victorconka/emergency_button/README.md

# Emergency Button  
## About  
"emergency button" project based on attiny85, nrf24l01, esp8266 based devboard, telegram and email API's  
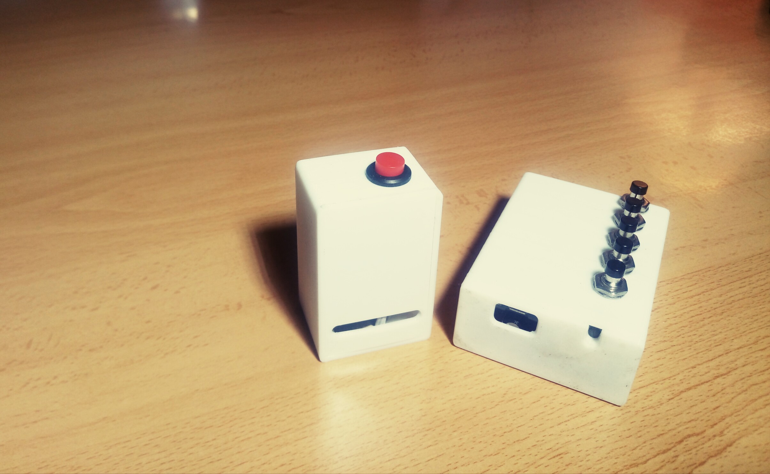
[picture p1: imgs/IMG_20171120_012127_170.jpg]
Server and Emergency Button
  
### Main funcions:  
*     	Attend Telegram Commands.  
*     	Telegram Authorization (access control).  
*     	Listen for the Alert button being pressed.  
*     	Send WOL packet to the PC.  
*     	Send Ping packets to the configured IP Address.  
### Folder contains:  
* UML project files.  
* Enclosure for both, button and server. (opensource, not mine).  
* libraries used to compile arduino files for the server since the compilation is tricky because of the number of libraries used and available SRAM.  
* The code for Arduino IDE.  
* Schematics for the circuits (be aware that some of the part libraries were missing, so same shape parts were used.)  
  
## Configuration  
### Server  
#### Schematic:  
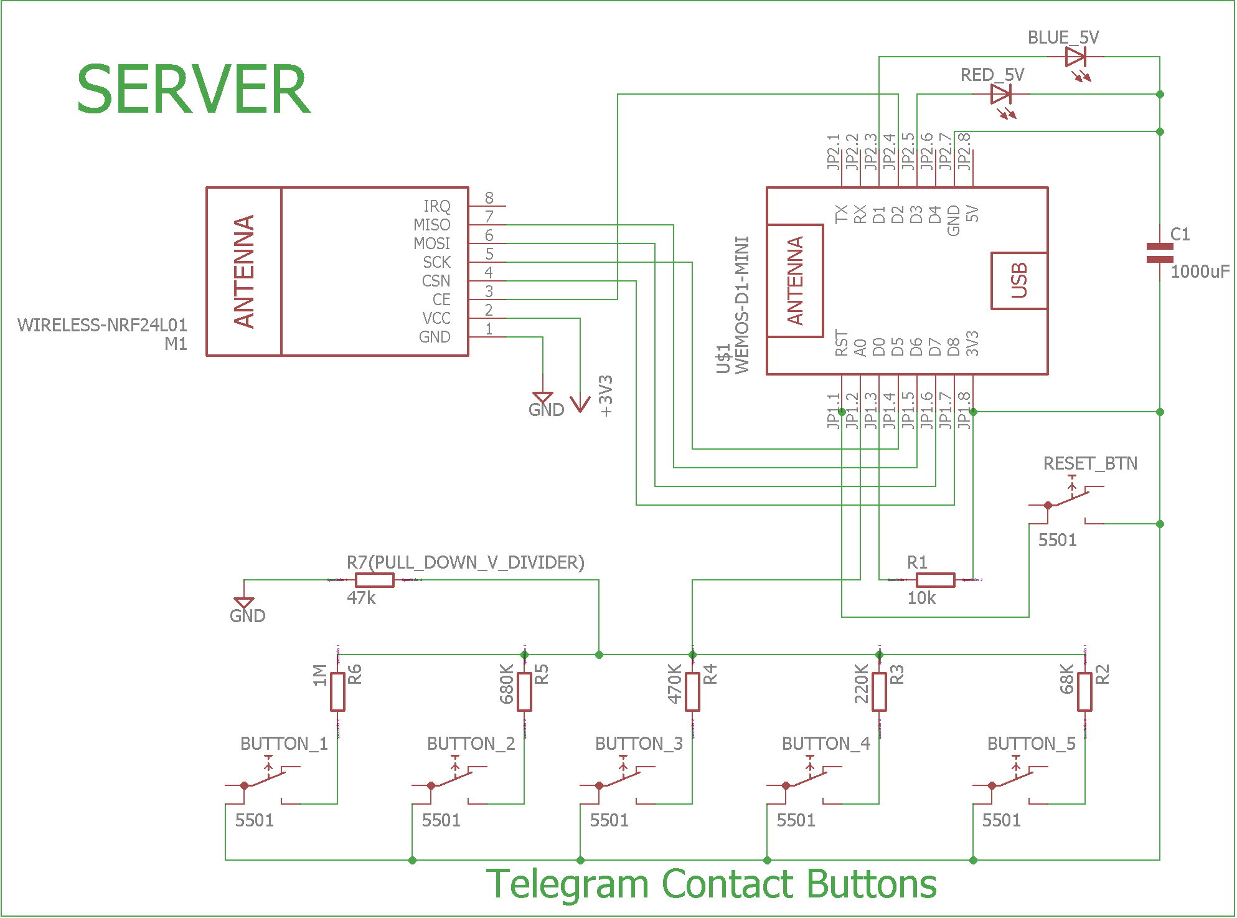
[picture p2: imgs/server_schematic2.png]
Emergency Button Server Schematic
  
#### PCB  
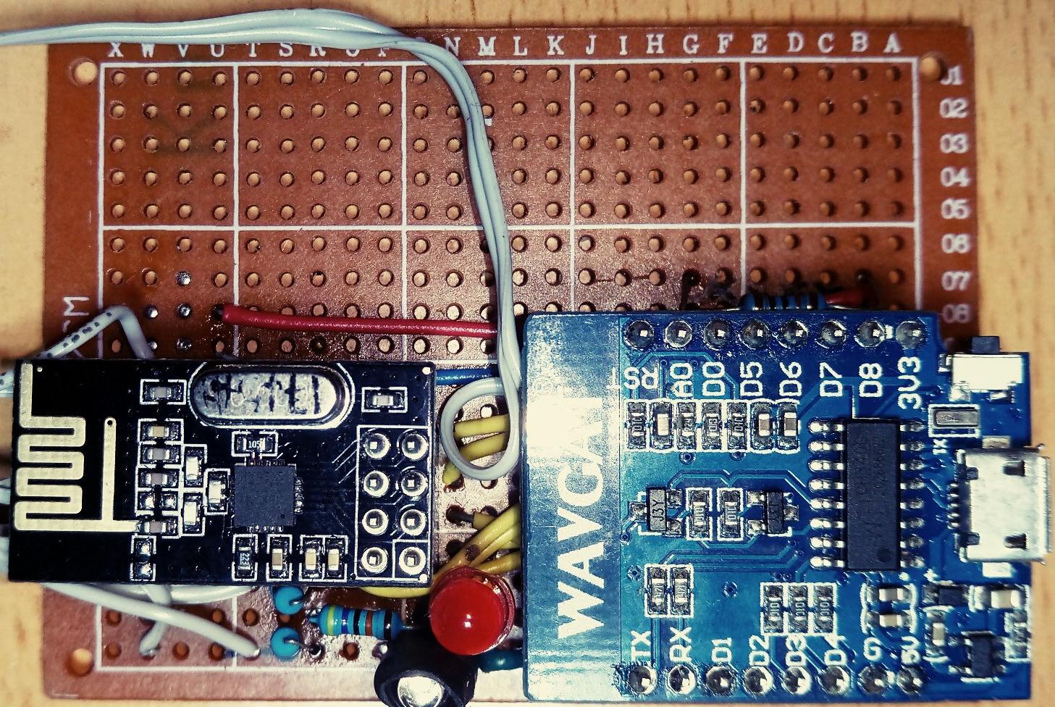
[picture p3: imgs/IMG_20171120_180733_227_cr.jpg]
server protoboard pcb
  
### Emergency Button  
#### Schematic  
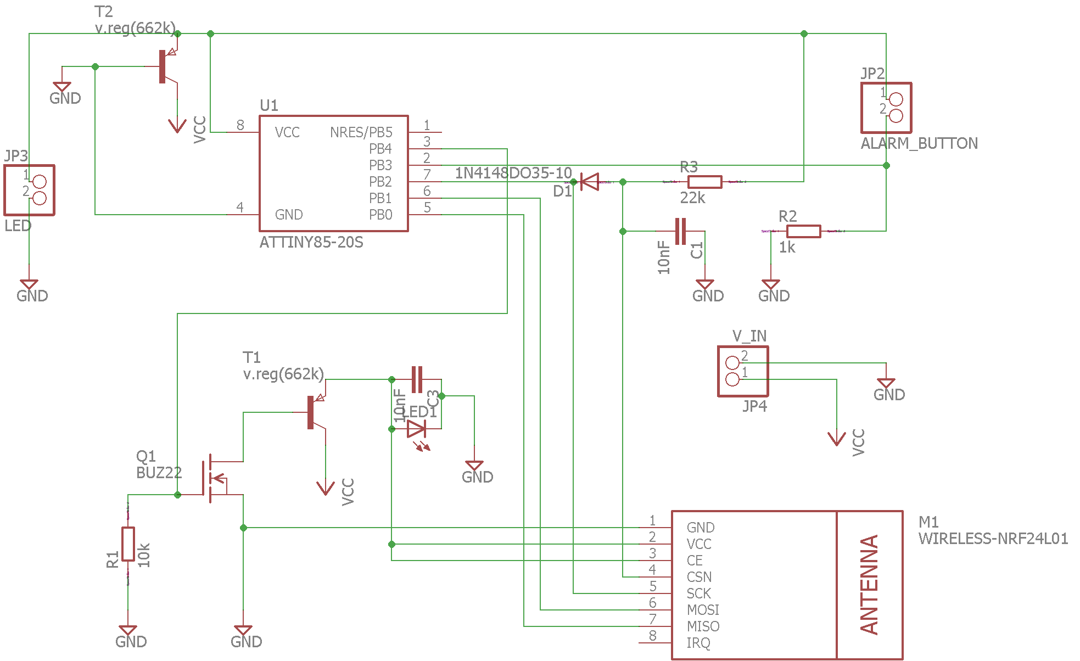
[picture p4: imgs/schematic_vck_v1.5.1..png]
emergency button schematic
  
#### PCB Layout  
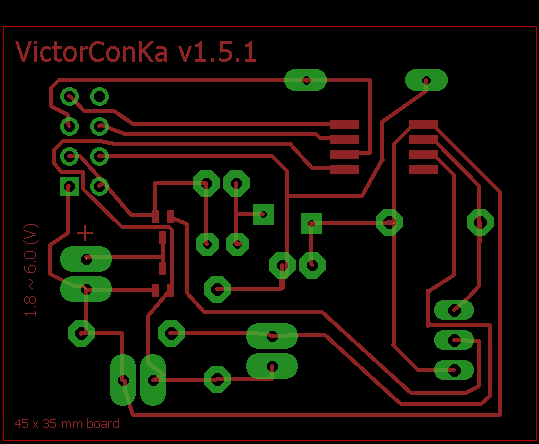
[picture p5: imgs/vck_v1.5.1.png]
emergency button pcb layout
  
#### PCB Implementation  
##### BACK
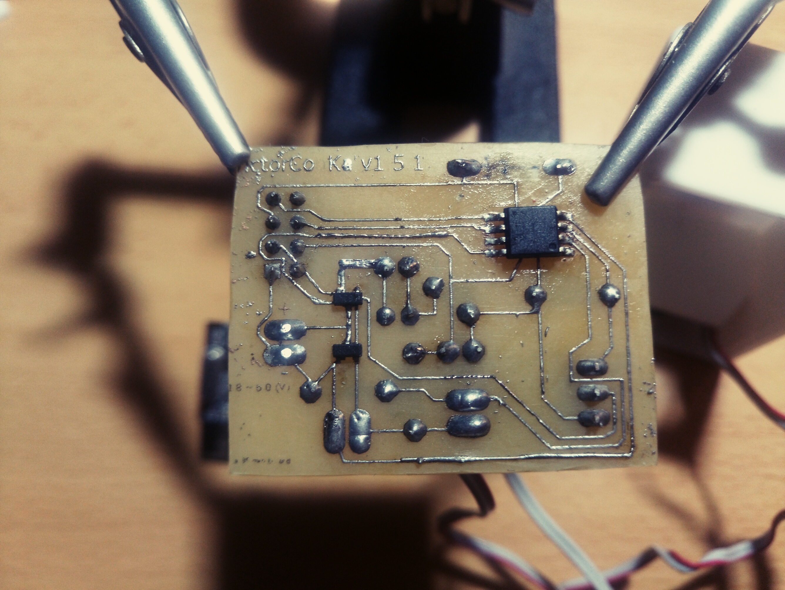
[picture p6: imgs/IMG_20171120_164349_951.jpg]
emergency button pcb implementation back
  
##### FRONT
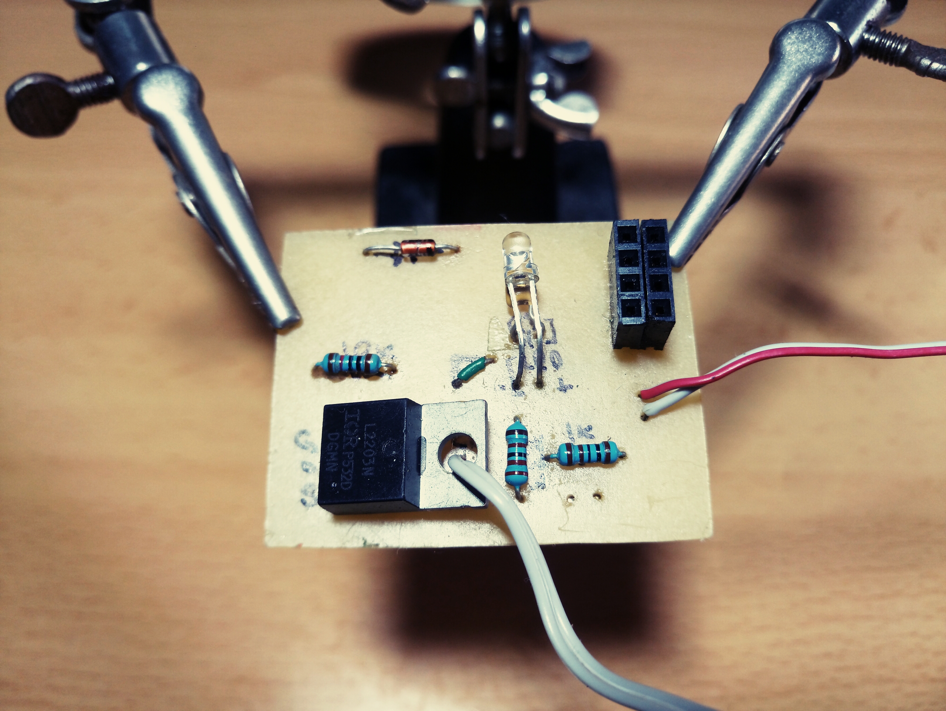
[picture p7: imgs/IMG_20171120_163525_609.jpg]
emergency button pcb implementation fron
  
#### Battery Consumption  
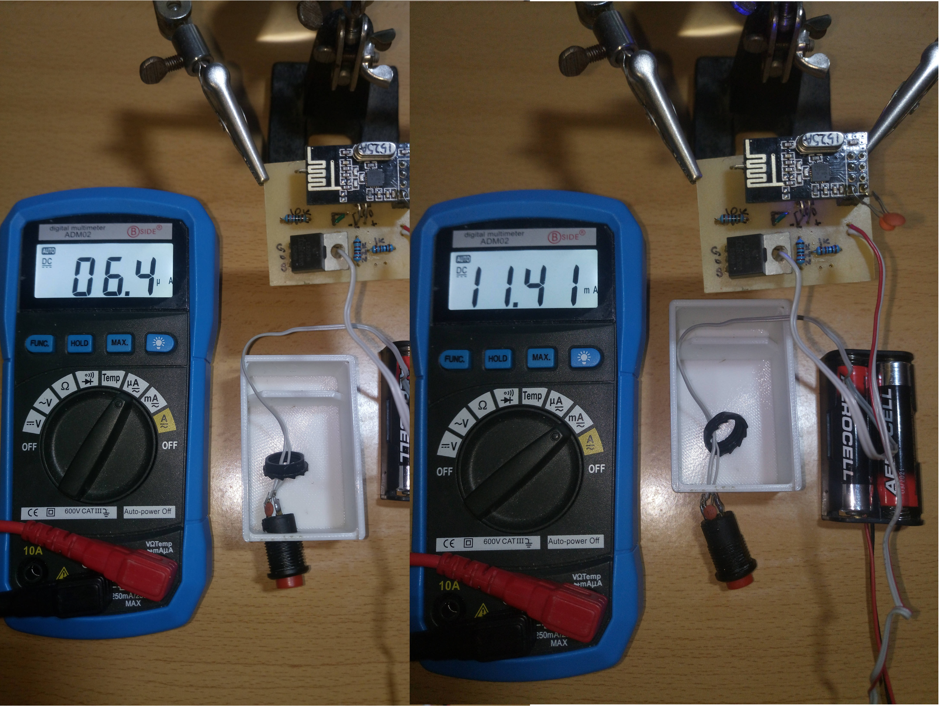
[picture p8: imgs/emergency_button_energy_consumption.jpg]
emergency button battery consumption
  
## Further Improvements  
### Battery improvement  
Only a step-down voltage regulator is included in the circuit. This means we can use batteries with voltage values up to 6V. Battery voltage will be stepped down to 3.3V, which is the value at which the circuit operates.  
Device uses CR2032 batterie which nominal value is 3V. Once it's charge goes under 2.6V, NRF24L01 is unable to operate properly.  
Adding an additional step up resistor will consume some extra microAmps, but in exchange the battery will get dryed out down to 0.8V.
