victorconka/emergency_button/SERVER/ARDUINO/README.MD

## Arduino nano, nrf24 and led to test the button functionality.  
##can be easily ported to esp8266 based platforms, assigning cs, rst and led pins properly (Dn)
