victorconka/emergency_button/SERVER/EAGLE/server schematic.png

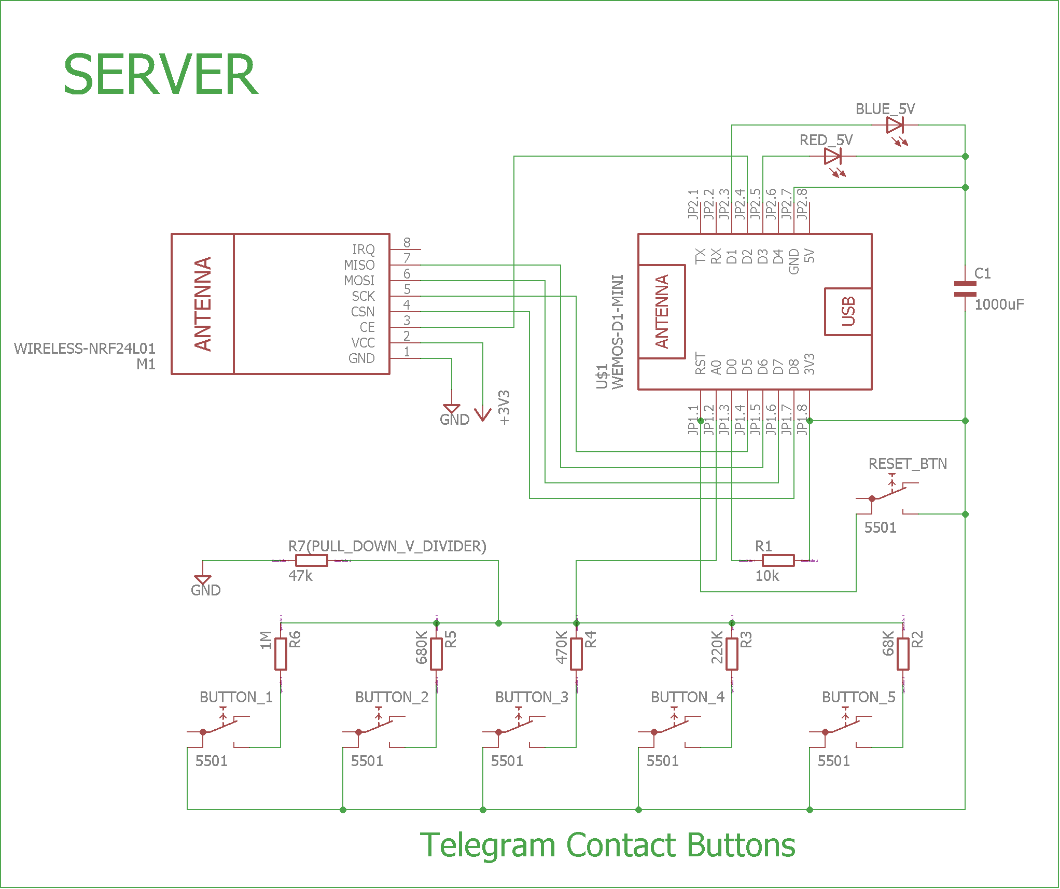
SERVER/EAGLE/server schematic.png
