victorconka/emergency_button/ENCLOSURE CASE/serverBox/protoEnclosureBox.stl

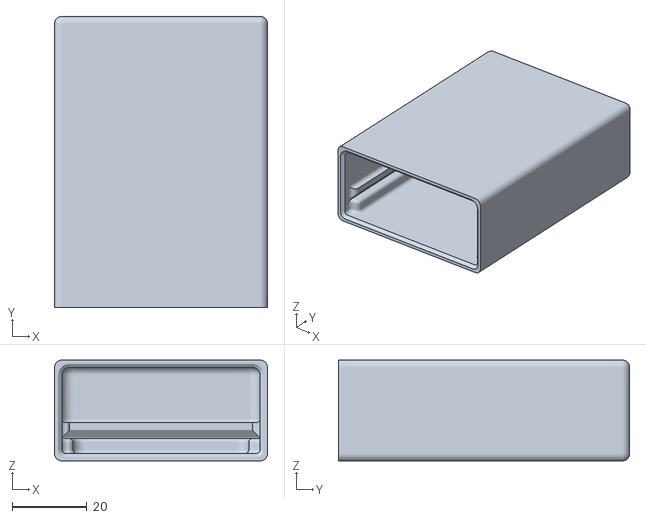
[picture p10: CAD file, 2017-09-11]
ENCLOSURE CASE/serverBox/protoEnclosureBox.stl
57.0 x 78.0 x 27.0
