victorconka/emergency_button/ENCLOSURE CASE/serverBox/protoEnclosureLidGroveUsb.stl

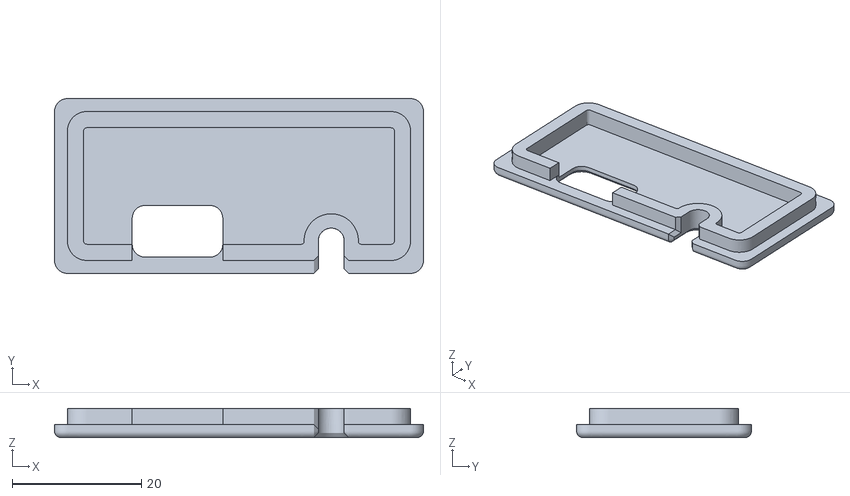
[picture p11: CAD file, 2017-09-11]
ENCLOSURE CASE/serverBox/protoEnclosureLidGroveUsb.stl
57.0 x 27.0 x 4.50
