victorconka/emergency_button/BUTTON/EAGLE/BUTTON_v1.5.1/print/vck_v1.5.1_matrix.pdf

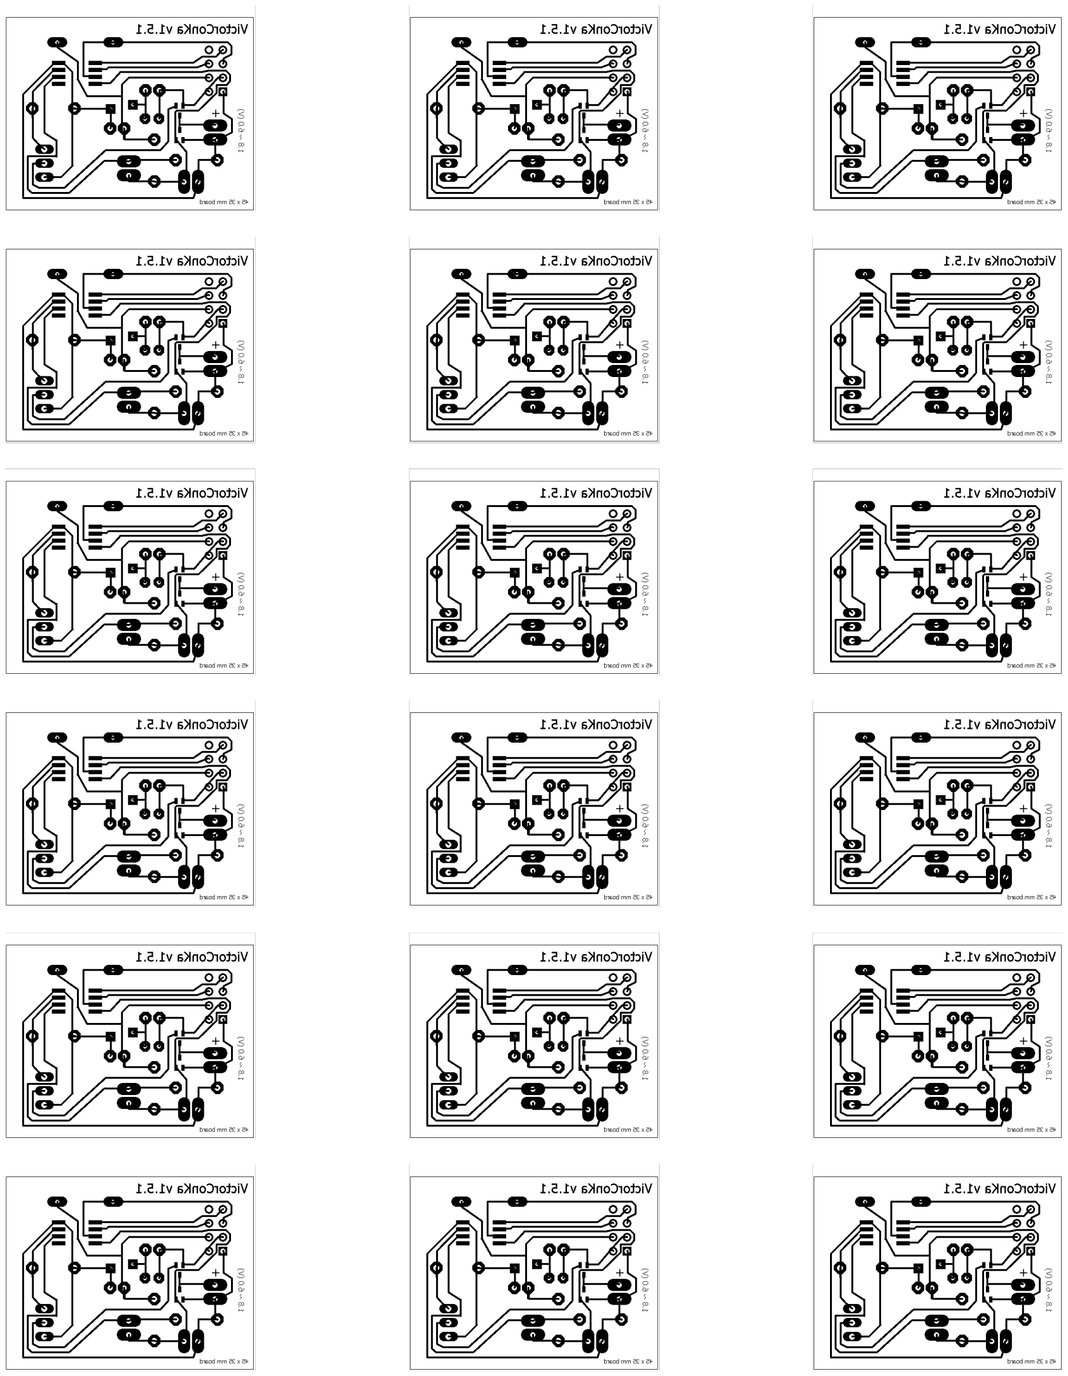
[picture p12: page 1]
