victorconka/emergency_button/BUTTON/EAGLE/BUTTON_v1.5.1/print/pcb_vck_v1.5.1..png

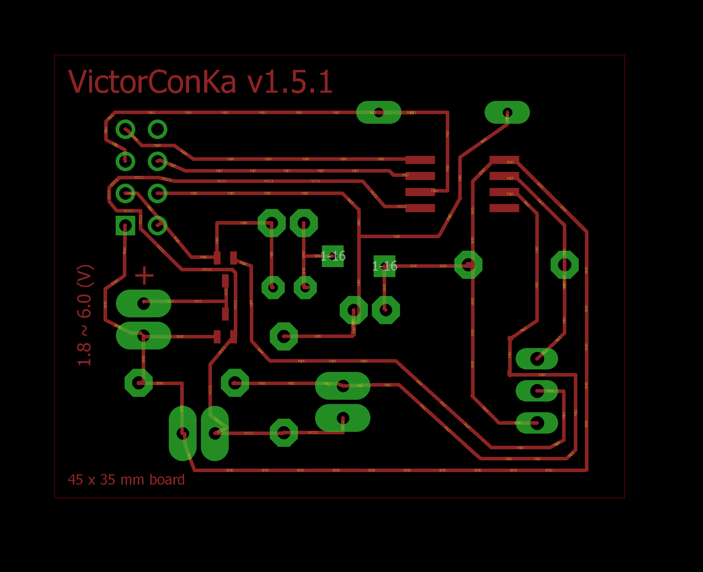
BUTTON/EAGLE/BUTTON_v1.5.1/print/pcb_vck_v1.5.1..png
