victorconka/emergency_button/BUTTON/EAGLE/BUTTON_v1.5.1/print/vck_v1.5.1_volteada.png

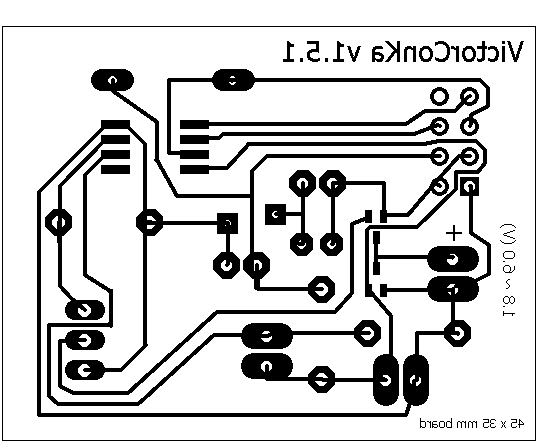
BUTTON/EAGLE/BUTTON_v1.5.1/print/vck_v1.5.1_volteada.png
