victorconka/emergency_button/BUTTON/EAGLE/BUTTON_v1.5.1/schem5.brd

## EAGLE design BUTTON/EAGLE/BUTTON_v1.5.1/schem5.brd (2017-08-28)

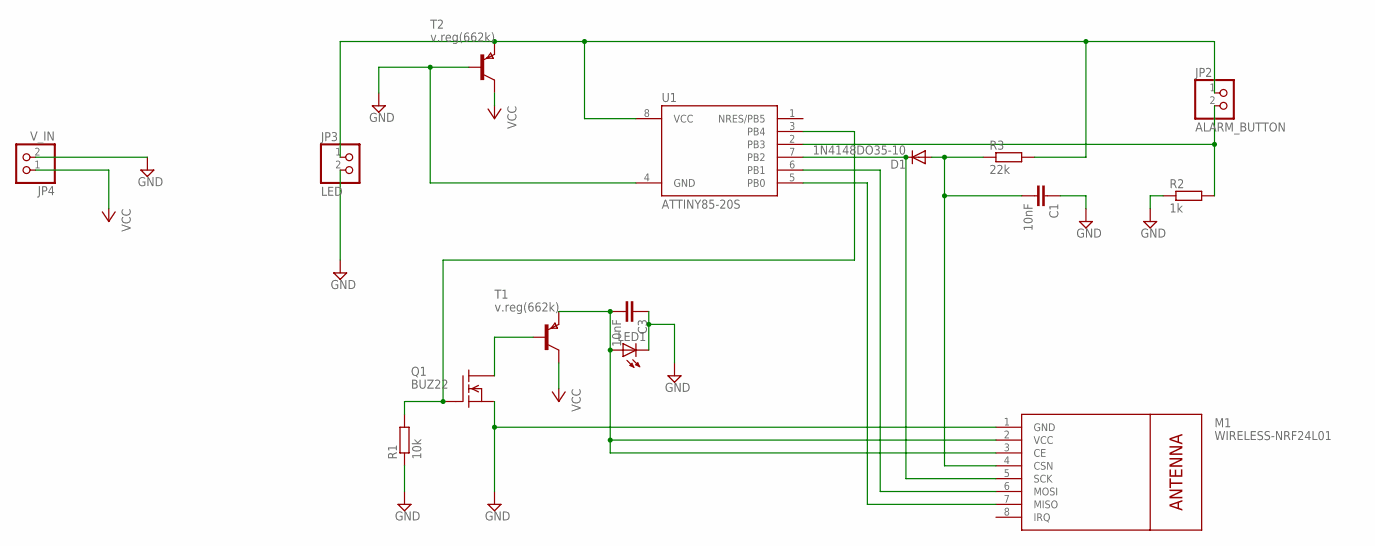
[picture p16: schematic schem5.sch]

Parts:
C1, C3: 10nF; C2.5-2
D1: 1N4148DO35-10; DO35-10
JP2: ALARM_BUTTON; 1X02
JP3: LED; 1X02
JP4: V_IN; 1X02
LED1: LED5MM
M1: WIRELESS-NRF24L01
Q1: BUZ22; TO220
R1: 10k; 0204/7
R2: 1k; 0204/7
R3: 22k; 0204/7
T1, T2: v.reg(662k); SOT323
U1: ATTINY85-20S; SOIC8_EIAJ_208MIL

Connections:
GND: C1.1, C3.1, JP3.2, JP4.2, LED1.K (C), M1.1 (GND), Q1.3 (S), R1.1, R2.1, T2.2 (B), U1.4 (GND)
unnamed: D1.C, M1.5 (SCK), U1.7 (PB2)
unnamed: JP2.2, R2.2, U1.2 (PB3)
unnamed: Q1.1 (G), R1.2, U1.3 (PB4)
unnamed: Q1.2 (D), T1.2 (B)
unnamed: C1.2, D1.A, M1.4 (CSN), R3.1
unnamed: C3.2, LED1.A, M1.2 (VCC), M1.3 (CE), T1.3 (E)
unnamed: M1.6 (MOSI), U1.6 (PB1)
unnamed: M1.7 (MISO), U1.5 (PB0)
VCC: JP4.1, T1.1 (C), T2.1 (C)
VCC1: JP2.1, JP3.1, R3.2, T2.3 (E), U1.8 (VCC)

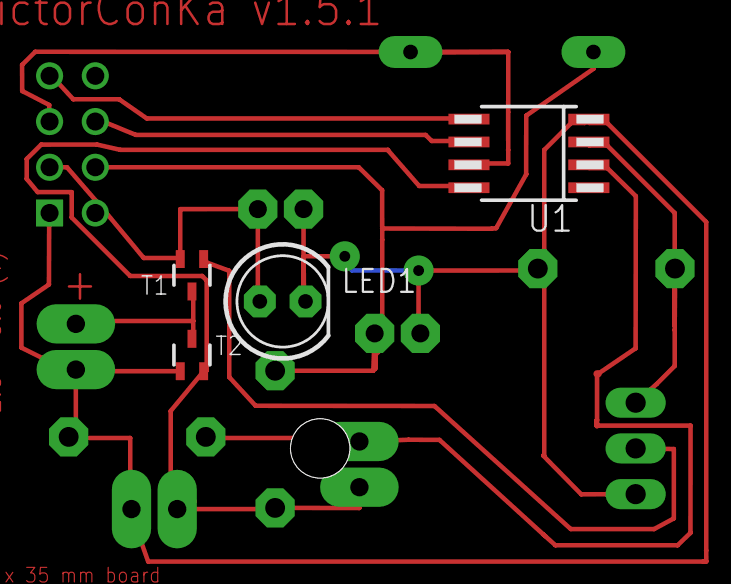
[picture p17: board schem5.brd from above]

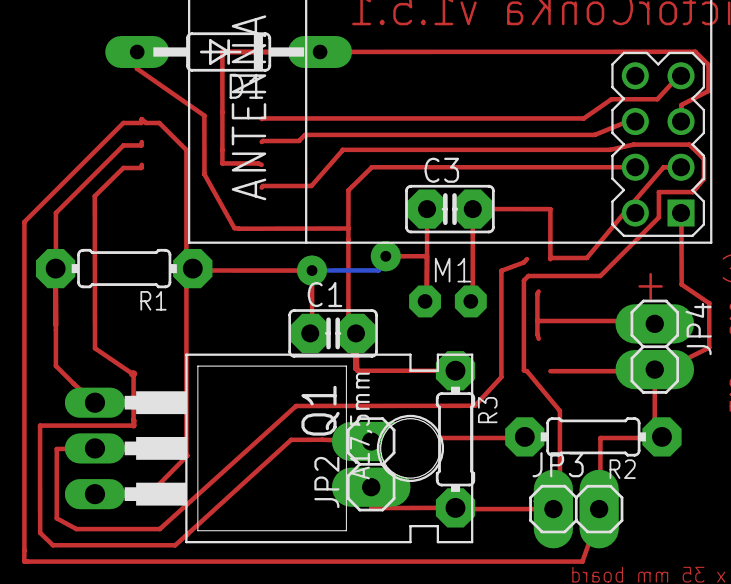
[picture p18: board schem5.brd from below]

Board: 2 copper layers, 15 parts (11 on the bottom side), 11 nets.
