victorconka/emergency_button/SERVER/EAGLE/Server.sch

## EAGLE design SERVER/EAGLE/Server.sch (2017-10-31)

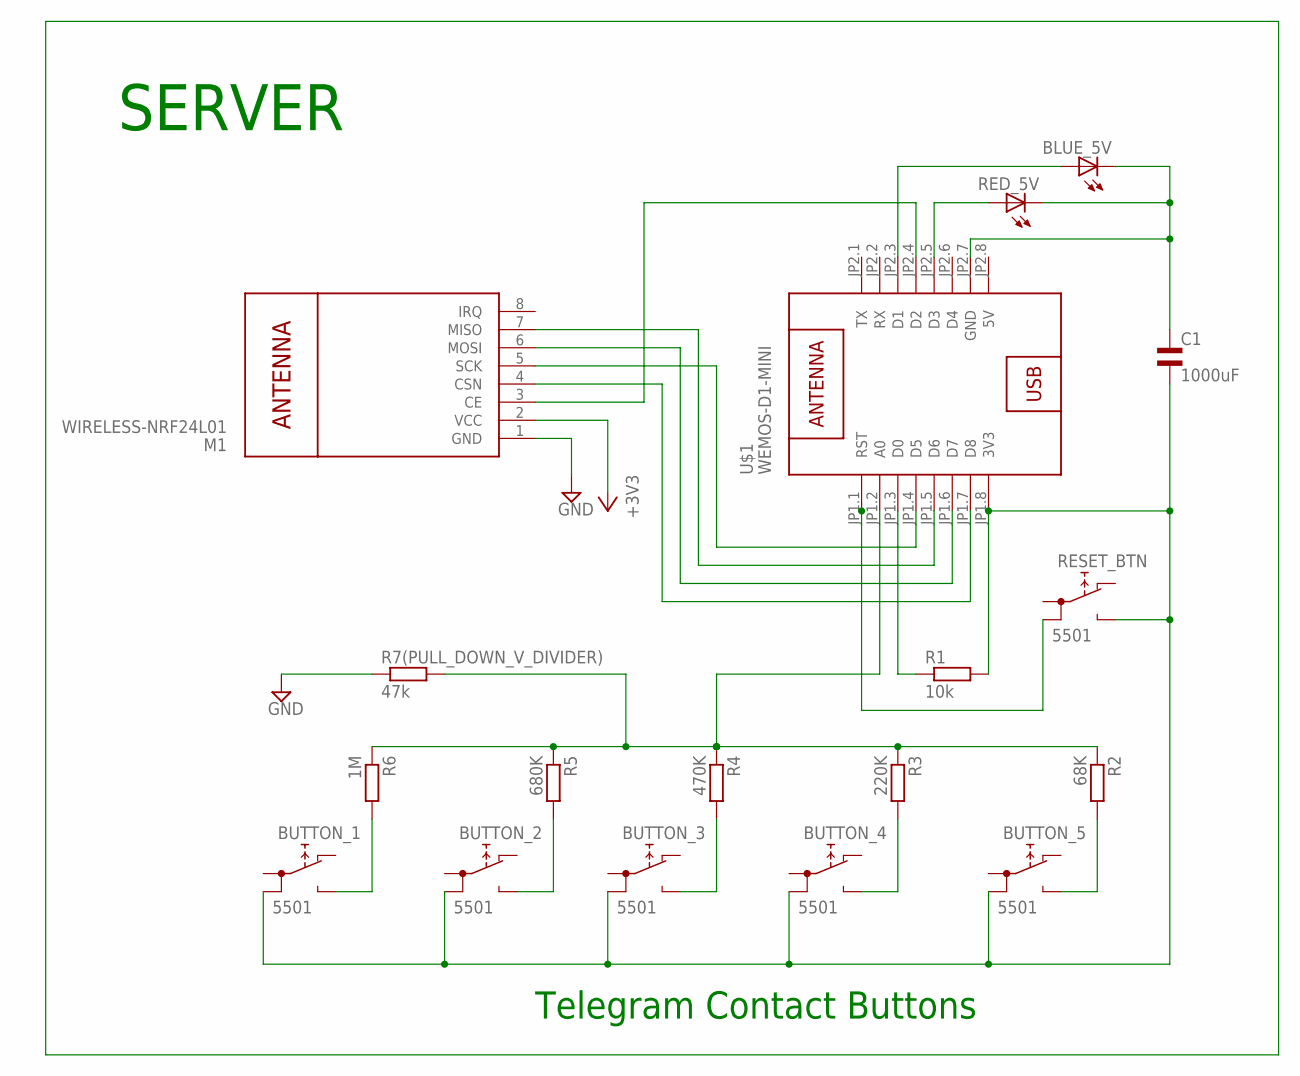
[picture p19: schematic Server.sch]

Parts:
BLUE_5V: LED5MM
BUTTON_1, BUTTON_2, BUTTON_3, BUTTON_4, BUTTON_5: 5501
C1: 1000uF; EU35-12
M1: WIRELESS-NRF24L01
R1: 10k; 0207/10
R2: 68K; 0207/10
R3: 220K; 0207/10
R4: 470K; 0207/10
R5: 680K; 0207/10
R6: 1M; 0207/10
R7(PULL_DOWN_V_DIVIDER): 47k; 0207/10
RED_5V: LED5MM
RESET_BTN: 5501
U$1: WEMOS-D1-MINI

Connections:
+3V3: M1.2 (VCC)
GND: M1.1 (GND), R7(PULL_DOWN_V_DIVIDER).1
unnamed: R2.1, R3.1, R4.1, R5.1, R6.1, R7(PULL_DOWN_V_DIVIDER).2, U$1.JP1.2 (A0)
unnamed: BUTTON_1.NO, R6.2
unnamed: BUTTON_2.NO, R5.2
unnamed: BUTTON_3.NO, R4.2
unnamed: BUTTON_4.NO, R3.2
unnamed: BUTTON_5.NO, R2.2
unnamed: M1.5 (SCK), U$1.JP1.4 (D5)
unnamed: M1.7 (MISO), U$1.JP1.5 (D6)
unnamed: R1.1, U$1.JP1.3 (D0)
unnamed: RESET_BTN.1B, U$1.JP1.1 (RST)
unnamed: BUTTON_1.1B, BUTTON_2.1B, BUTTON_3.1B, BUTTON_4.1B, BUTTON_5.1B, C1.2, R1.2, RESET_BTN.NO, U$1.JP1.8 (3V3)
unnamed: M1.6 (MOSI), U$1.JP1.6 (D7)
unnamed: M1.4 (CSN), U$1.JP1.7 (D8)
unnamed: RED_5V.A, U$1.JP2.5 (D3)
unnamed: BLUE_5V.A, U$1.JP2.3 (D1)
unnamed: BLUE_5V.K (C), C1.1, RED_5V.K (C), U$1.JP2.7 (GND)
unnamed: M1.3 (CE), U$1.JP2.4 (D2)

Notes on the sheet:
Telegram Contact Buttons
SERVER
