victorconka/emergency_button/BUTTON/ATTINY85/senderACKSleep_v2/senderACKSleep_v2.ino

/**
 * Sender assumes the role of the button. button sends the message.
 */

#include "nRF24L01.h"
#include "RF24.h"
#include <avr/sleep.h>
#include <avr/interrupt.h>

//these pins are never used.
//configuration necessary to activate 3 pin configuration.
#define CE_PIN 3
#define CSN_PIN 3 //IF we are using 3 pin configuration we will use same pin for both CE and CSN, E.G. pin 3

#define BTN_PIN 3 // if used a differen button to pb3, sleep interrupt button needs to be changed
#define NRF_VCC_PIN 4 //pin that powers nrf24l01.

RF24 radio(CE_PIN, CSN_PIN);  //NRF24 object
const byte rxAddr[][7] = {"server","button"}; //device roles
byte counter = 1; //value that will be sent to the other device
byte resetCounter = 0; // counter to detect nrf malfunctions
boolean bReleased = HIGH; //variable used to avoid click release being activated. in other words, when button is pressed, the action is  performed once.
boolean messageDelivered = true;  //flag to know wheather the message was delivered
byte gotByte = 0; //ACK message value

void setup() {
  pinMode(BTN_PIN, INPUT);
  pinMode(NRF_VCC_PIN, OUTPUT);
}

/**
 * turn on and initialize nrf module
 */
void nrfON(){
//---------------------NRF-CONFIGURATION------------------------------------------------ 
  digitalWrite(NRF_VCC_PIN,HIGH); // turn nrf_vcc ON
  delay(50);
//--------------------------------------------------------------------------------------
  radio.begin(); // Start up the radio
  radio.setChannel(126);
  radio.setPALevel(RF24_PA_MAX);
  radio.setDataRate(RF24_250KBPS);
  radio.setAutoAck(1); // Ensure autoACK is enabled
  radio.setRetries(15,15); // Max delay between retries & number of retries
  radio.setCRCLength(RF24_CRC_8);          // Use 8-bit CRC for performance
  radio.enableAckPayload();               // Allow optional ack payloads
  radio.openWritingPipe(rxAddr[0]); // Write to device address 'server'
  radio.openReadingPipe(1,rxAddr[1]); // Read on pipe 1 for device address 'button'
  radio.powerUp();  
//--------------------------------------------------------------------------------------  
}

/**
 * power down first to reduce the power spike when the power is cut.
 */
void nrfOFF(){
  radio.powerDown(); 
  digitalWrite(NRF_VCC_PIN,LOW);//turn nrf_vcc off
}

/**
 * manages resetCounter boolean value
 * to make sure problem is not nrf module
 * and it's the out of reach situation.
 */
void manageCounter(){
  resetCounter++;
  if(resetCounter == 50){
    nrfOFF();
    delay(250);
    nrfON();
    resetCounter=0;
  }
  delay(100);
}

/**
 * send message until ack is received.
 */
void writeMSG(){
  //WRITE MESSAGE
  while(!radio.writeFast( &counter, 1 )){
    //NRF MODULE HAS ISSUES OR SERVER IS OUT OF REACH
    manageCounter();
  }
  //READ ACK
  if(radio.available() ){
    //listeing to incomming ack
    gotByte = 0; //value that will never be received
    radio.read( &gotByte, 1 ); //read message
    resetCounter = 0; //radio working fine - wrong answer, reset counter to 0
    if((counter+1) == gotByte){
      messageDelivered = true;//notify loop that message was delivered    
      if(counter > 200){
        counter = 1;
      }else{
        counter++;
      }
    }
  }
  if(!messageDelivered){
    writeMSG();
  }
}

/**
 * attiny necesary register configuration to sleep until an interrupt on pin 3 occurs.
 * Original code taken from here:
 * https://bigdanzblog.wordpress.com/2014/08/10/attiny85-wake-from-sleep-on-pin-state-change-code-example/
 */
void sleep() {
    GIMSK |= _BV(PCIE);                     // Enable Pin Change Interrupts
    PCMSK |= _BV(PCINT3);                   // Use PB3 as interrupt pin
    ADCSRA &= ~_BV(ADEN);                   // ADC off
    set_sleep_mode(SLEEP_MODE_PWR_DOWN);    // replaces above statement

    sleep_enable();                         // Sets the Sleep Enable bit in the MCUCR Register (SE BIT)
    sei();                                  // Enable interrupts
    sleep_cpu();                            // sleep

    cli();                                  // Disable interrupts
    PCMSK &= ~_BV(PCINT3);                  // Turn off PB3 as interrupt pin
    sleep_disable();                        // Clear SE bit
    ADCSRA |= _BV(ADEN);                    // ADC on

    sei();                                  // Enable interrupts
} // sleep

ISR(PCINT0_vect) {
    // This is called when the interrupt occurs, but I don't need to do anything in it
    // to send the message once, it is enough to put it inside the loop.
    // besides, the nrf initialization wasn't fuctioning correctly when put here.
}

void loop(void){
  sleep();
  //button press means 2 actions (press and unpress).
  //in order to send the message once, we have to use variable
  //to control such a situation.
  if (bReleased) { // is button in released state (open)
    bReleased = LOW; // button is now in pressed state (closed)
    messageDelivered = false; //start up with message not delivered
    nrfON();
    writeMSG(); //send the message
    nrfOFF();
  }else { // button was in presse state so has been released
    bReleased = HIGH; // so set flag and go take a nap
  }
}
