victorconka/emergency_button/SERVER/ARDUINO/ServerController/common.ino

void alert(){
if (DEBUG){
  Serial.println(F("alert()"));
}
  toggle('b');
  //ENABLE ALERT AND SAVE CONFIGURATION TO INTERNAL MEMORY
  ALERT = true;
  saveConfig();
  
  // TRIGGER IFTTT
  triggerIFTTT("");
  
  // ALERT TELEGRAM
  String alertMsg = "ALERT BUTTON PRESSED";
  sendMsg(telegram_group,alertMsg);
  for(uint8_t i = 0;i < numContacts; i++){
    if(telegram_contacts[i] != EMPTY){
      sendMsg(telegram_contacts[i],alertMsg);    
    }
  }
  
  //TURN ON PC
  sendWOLPacket();
  
  //DISABLE ALERT AND SAVE CONFIGURATION TO INTERNAL MEMORY
  ALERT = false;
  saveConfig();
  toggle('b');
}

/**
 * COMMON
 * Read analog button value and decide what button was pressed.
 * Buttons are connected to different resistor values, therefore
 * each button gives a different value when read.
 */
void readButtons(){
  btn = analogRead(button)/100;
  if(btn>0){
    //read stable value. assign max value.
    int btnStable = 0;
    for(uint8_t i = 0;i < 5; i++){
      btnStable = analogRead(button);
      btnStable = btnStable/100;
      if(btnStable > btn){
        btn = btnStable;  
      }
    }
    if (DEBUG){
      Serial.print(F("Button value: "));
      Serial.println(btn);
    }
    if(btn == 5){
      btn = 4;
    }else if(btn == 8 || btn == 7 || btn == 6){// 6&7&8 HAVE SIMILAR RESISTOR VALUES
      btn = 5;
    }
    
    // TURN ON BLUE LED TO SHOW THAT BUTTON WAS READ
    toggle('b');
    if(!contactPerson(btn)){
      //DELAY AND TURN OFF BLUE LED
      delay(300);
      toggle('b');
      // TOGGLE RED TO NOTIFY THAT NO CONTACT IS PROGRAMMED OR COULDN'T NOTIFY
      toggleOnce('r');
    }else{
      toggle('b');
      // TOGGLE ONCE MORE TO CONFIRM MESSAGE SENT
      toggleOnce('b');
    } 
  }
}
/**
 * COMMON
 * TOGGLE LED ONCE
 * Turn led on and off
 */
void toggleOnce(char ledColor){
if (DEBUG){
  Serial.println(F("toggleOnce()"));
}   
  toggle(ledColor);
  delay(300);
  toggle(ledColor);
}

/**
 *  COMMON
 *  Toggle led from low to high and viceversa 
 */
void toggle(char color){
  
    if (DEBUG){
    Serial.println(F("toggle()")); 
    Serial.println(ESP.getFreeHeap()); 
    }
  if(ledState){
    ledState = false;  
    if(color == 'b'){
      digitalWrite(blueLed, LOW);
    }else if(color == 'r'){
      digitalWrite(redLed, LOW);
    }
  }else{
    ledState = true;
    if(color == 'b'){
      digitalWrite(blueLed, HIGH);
    }else if(color == 'r'){
      digitalWrite(redLed, HIGH);
    }
  }
}
