victorconka/emergency_button/(commit log)

2017-08-28 button code and schematic
    [schem5.brd, schem5.sch]
2017-09-11 button read and toggle once
    [protoEnclosureBox.stl, protoEnclosureLidGroveUsb.stl]
2017-10-31 working server version and modified button code which was refactored to make it more readable and remove recursion
2017-10-31 server schematic added
    [Server.sch]
2017-12-04 some fixes
    [schem5.sch]
